arthurbenemann/QuadStepDriver/Gerber/QuadStepDriver.TXT

%
M48
M72
T01C0.0150
T02C0.0200
T03C0.0236
T04C0.0374
T05C0.0400
T06C0.0550
T07C0.0906
T08C0.1300
%
T01
X7240Y15015
X7240Y15390
X7240Y15790
X7640Y15790
X7640Y15390
X7640Y14990
X8040Y14990
X8040Y15390
X8040Y15790
X17083Y15790
X17483Y15790
X17883Y15790
X17883Y15390
X17883Y14990
X17483Y14990
X17483Y15390
X17083Y15390
X17083Y15015
X26925Y15015
X26925Y15390
X26925Y15790
X27325Y15790
X27325Y15390
X27325Y14990
X27725Y14990
X27725Y15390
X27725Y15790
X36768Y15790
X37168Y15790
X37568Y15790
X37568Y15390
X37568Y14990
X37168Y14990
X37168Y15390
X36768Y15390
X36768Y15015
T02
X36168Y14140
X35918Y13765
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
