arthurbenemann/QuadStepDriver/(list of files, cad)

Other CAD files:
StepDriver.X/l.obj
