arthurbenemann/QuadStepDriver/QuadStepDriver.brd

## EAGLE design QuadStepDriver.brd (2013-06-29)

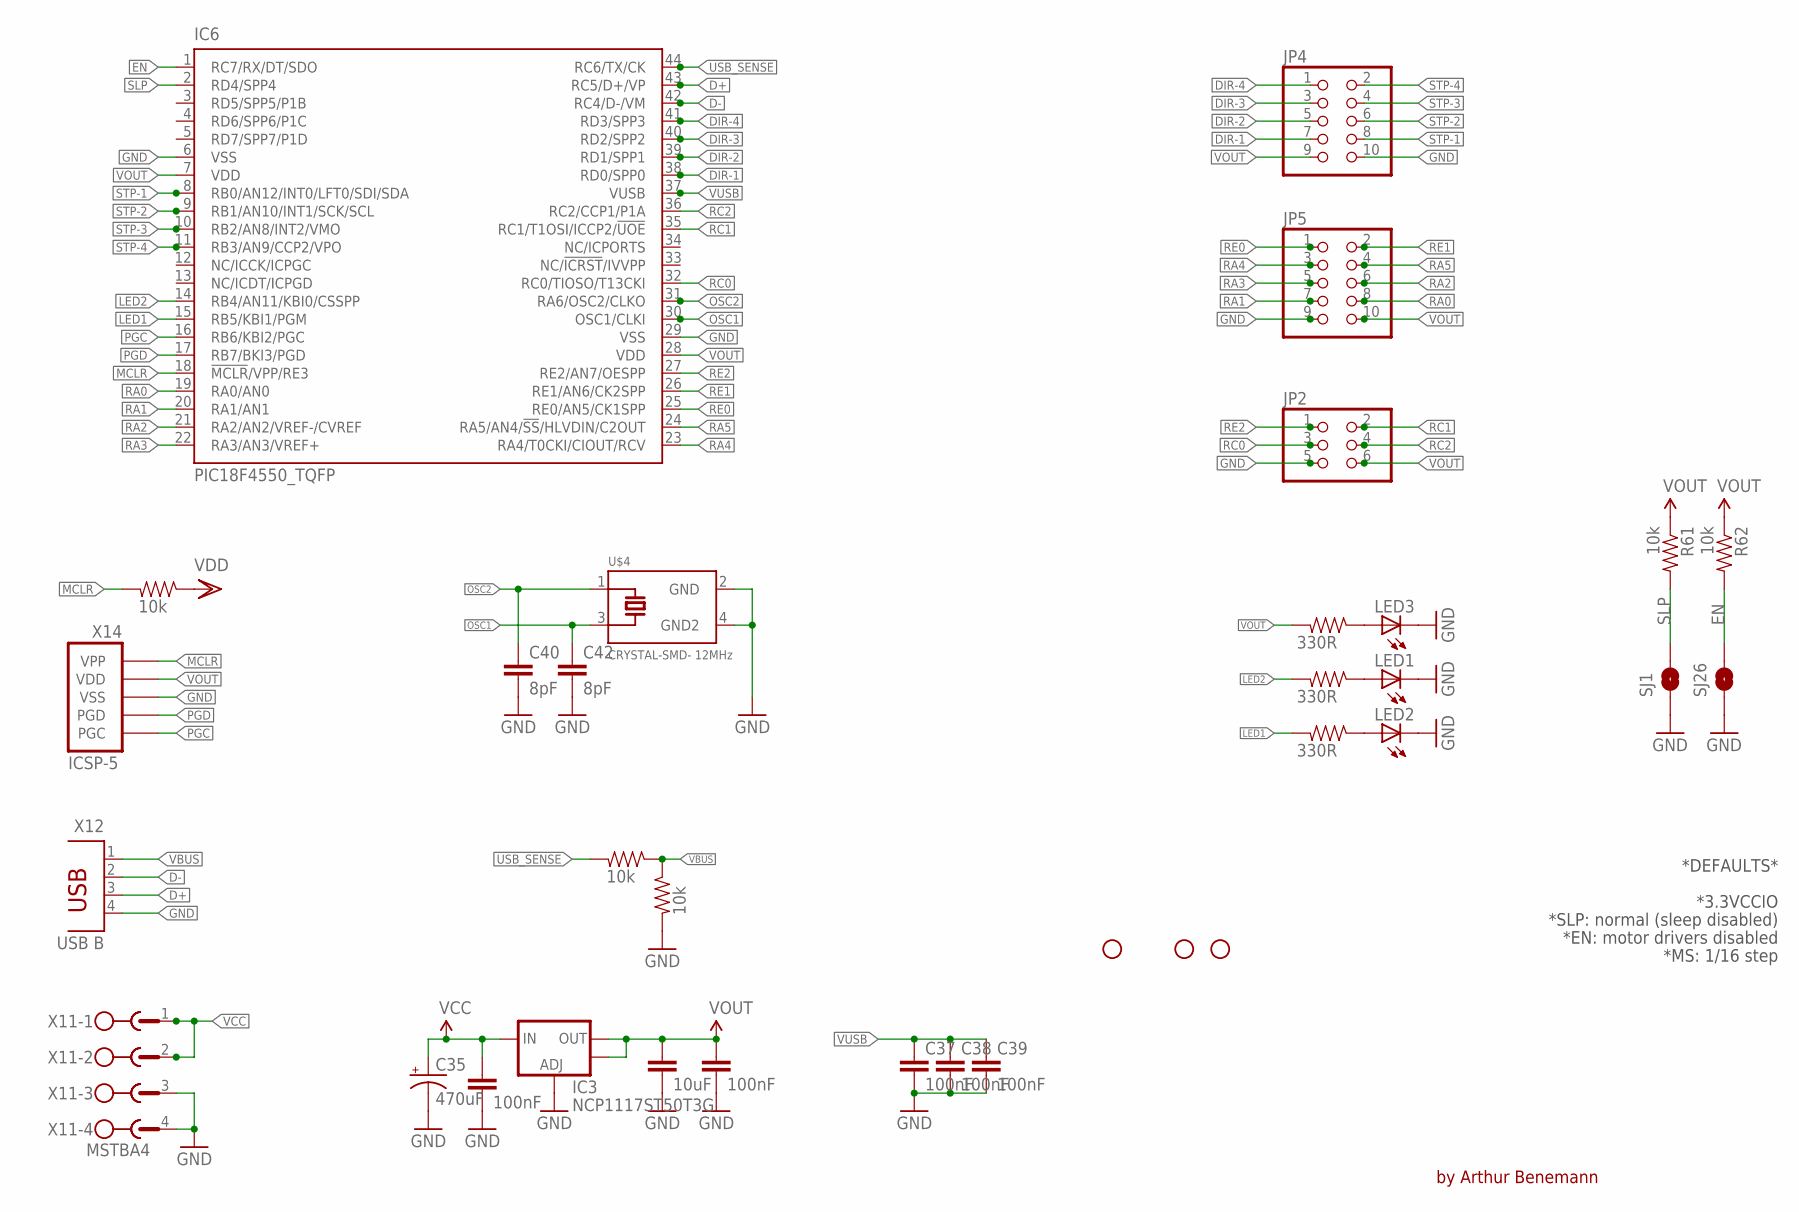
[picture p1: schematic QuadStepDriver.sch, sheet 1]

Parts:
C33: 10uF; 0805
C34, C36, C37, C38, C39: 100nF; 0805
C35: 470uF; PANASONIC_G
C40, C42: 8pF; 0603-CAP
IC3: NCP1117ST50T3G; SOT223
IC6: PIC18F4550_TQFP; TQFP44
JP2: PINHD-2X3; 2X03
JP4, JP5: PINHD-2X5; 2X05
JP9, JP10, JP12: STAND-OFF
LED1, LED2, LED3: LEDCHIPLED_0805; CHIPLED_0805
R33, R34, R35: 330R; 0805
R49, R50, R51: 10k; 0805
R61, R62: 10k; 0603-RES
SJ1, SJ26: SOLDERJUMPERNO; SJ_2S-NO
U$4: CRYSTAL-SMD- 12MHz; CRYSTAL-SMD-3.2X2.5
X11: MSTBA4
X12: USB B; PN61729
X14: ICSP-5; M05

Connections:
!MCLR: IC6.18 (!MCLR!/VPP/RE3), R51.2, X14.1 (VPP)
D+: IC6.43 (RC5/D+/VP), X12.3
D-: IC6.42 (RC4/D-/VM), X12.2
DIR-1: IC6.38 (RD0/SPP0), JP4.7; also elsewhere on the board
DIR-2: IC6.39 (RD1/SPP1), JP4.5; also elsewhere on the board
DIR-3: IC6.40 (RD2/SPP2), JP4.3; also elsewhere on the board
DIR-4: IC6.41 (RD3/SPP3), JP4.1; also elsewhere on the board
EN: IC6.1 (RC7/RX/DT/SDO), R62.2, SJ26.2; also elsewhere on the board
GND: C33.1, C34.1, C35.-, C36.1, C37.2, C38.2, C39.2, C40.2, C42.2, IC3.1 (ADJ), IC6.6 (VSS), IC6.29 (VSS), JP2.5, JP4.10, JP5.9, LED1.C, LED2.C, LED3.C, R50.2, SJ1.1, SJ26.1, U$4.2 (GND), U$4.4 (GND2), X11.3, X11.4, X12.4, X14.3 (VSS); also elsewhere on the board
LED1: IC6.15 (RB5/KBI1/PGM), R34.2
LED2: IC6.14 (RB4/AN11/KBI0/CSSPP), R33.2
unnamed: LED3.A, R35.1
unnamed: LED1.A, R33.1
unnamed: LED2.A, R34.1
OSC1: C42.1, IC6.30 (OSC1/CLKI), U$4.3 (OSC2)
OSC2: C40.1, IC6.31 (RA6/OSC2/CLKO), U$4.1 (OSC1)
PGC: IC6.16 (RB6/KBI2/PGC), X14.5 (PGC)
PGD: IC6.17 (RB7/BKI3/PGD), X14.4 (PGD)
RA0: IC6.19 (RA0/AN0), JP5.8
RA1: IC6.20 (RA1/AN1), JP5.7
RA2: IC6.21 (RA2/AN2/VREF-/CVREF), JP5.6
RA3: IC6.22 (RA3/AN3/VREF+), JP5.5
RA4: IC6.23 (RA4/T0CKI/CIOUT/RCV), JP5.3
RA5: IC6.24 (RA5/AN4/!SS!/HLVDIN/C2OUT), JP5.4
RC0: IC6.32 (RC0/TIOSO/T13CKI), JP2.3
RC1: IC6.35 (RC1/T1OSI/ICCP2/!UOE), JP2.2
RC2: IC6.36 (RC2/CCP1/P1A), JP2.4
RE0: IC6.25 (RE0/AN5/CK1SPP), JP5.1
RE1: IC6.26 (RE1/AN6/CK2SPP), JP5.2
RE2: IC6.27 (RE2/AN7/OESPP), JP2.1
SLP: IC6.2 (RD4/SPP4), R61.2, SJ1.2; also elsewhere on the board
STP-1: IC6.8 (RB0/AN12/INT0/LFT0/SDI/SDA), JP4.8; also elsewhere on the board
STP-2: IC6.9 (RB1/AN10/INT1/SCK/SCL), JP4.6; also elsewhere on the board
STP-3: IC6.10 (RB2/AN8/INT2/VMO), JP4.4; also elsewhere on the board
STP-4: IC6.11 (RB3/AN9/CCP2/VPO), JP4.2; also elsewhere on the board
USB_SENSE: IC6.44 (RC6/TX/CK), R49.2
VBUS: R49.1, R50.1, X12.1
VCC: C35.+, C36.2, IC3.3 (IN), X11.1, X11.2; also elsewhere on the board
VOUT: C33.2, C34.2, IC3.2 (OUT), IC3.4 (OUT), IC6.7 (VDD), IC6.28 (VDD), JP2.6, JP4.9, JP5.10, R35.2, R51.1, R61.1, R62.1, X14.2 (VDD); also elsewhere on the board
VUSB: C37.1, C38.1, C39.1, IC6.37 (VUSB)

Notes on the sheet:
*DEFAULTS*
*MS: 1/16 step
*3.3VCCIO
*EN: motor drivers disabled
*SLP: normal (sleep disabled)
by Arthur Benemann

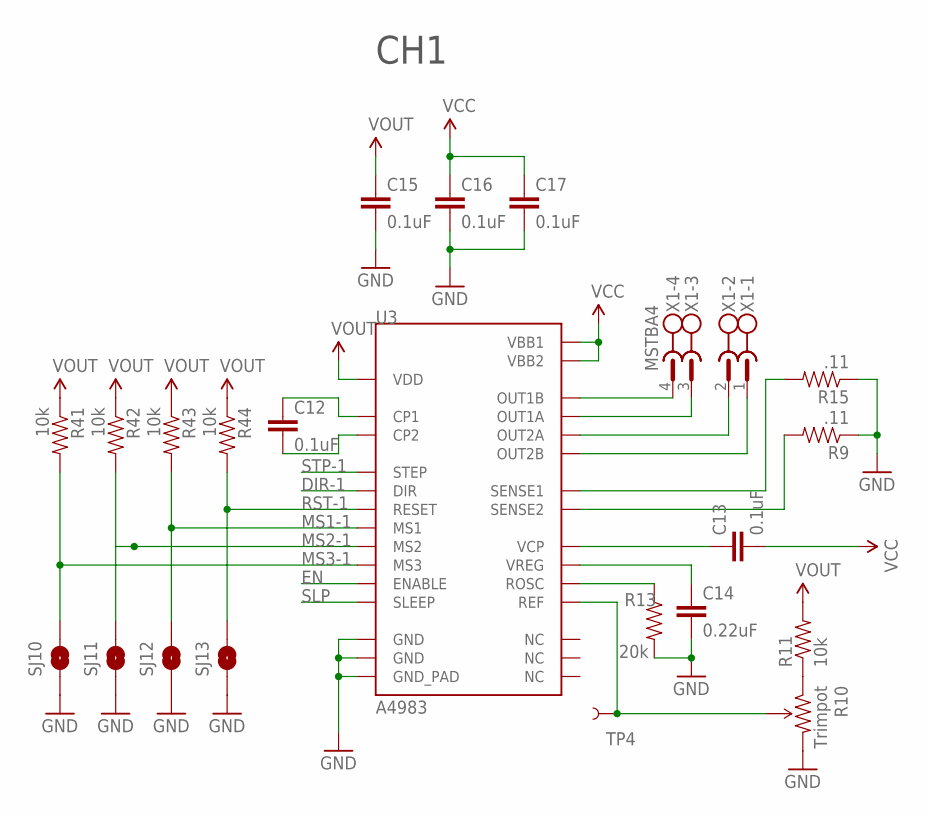
[picture p2: schematic QuadStepDriver.sch, sheet 2]

Parts:
C12, C13, C15, C16, C17: 0.1uF; 0603-CAP
C14: 0.22uF; 0603-CAP
R9, R15: .11; R2010
R10: Trimpot; TRIMPOT-3MM
R11, R41, R42, R43, R44: 10k; 0603-RES
R13: 20k; 0603-RES
SJ10, SJ11, SJ12, SJ13: SOLDERJUMPERNO; SJ_2S-NO
TP4: TEST-POINT3X5; PAD.03X.05
U3: A4983; QFN-28-5MM
X1: MSTBA4; MPN 1757268

Connections:
DIR-1: U3.P$19 (DIR); also elsewhere on the board
EN: U3.P$2 (ENABLE); also elsewhere on the board
GND: C14.2, C15.2, C16.2, C17.2, R9.1, R10.3 (CW), R13.2, R15.1, SJ10.1, SJ11.1, SJ12.1, SJ13.1, U3.P$3 (GND), U3.P$18 (GND), U3.P$29 (GND_PAD); also elsewhere on the board
MS1-1: R43.2, SJ12.2, U3.P$9 (MS1)
MS2-1: R42.2, SJ11.2, U3.P$10 (MS2)
MS3-1: R41.2, SJ10.2, U3.P$11 (MS3)
unnamed: R9.2, U3.P$27 (SENSE2)
unnamed: R15.2, U3.P$23 (SENSE1)
unnamed: R10.1 (CCW), R11.1
unnamed: C13.1, U3.P$6 (VCP)
unnamed: C14.1, U3.P$8 (VREG)
unnamed: R13.1, U3.P$13 (ROSC)
unnamed: R10.2 (WIPER), TP4.P$1, U3.P$17 (REF)
unnamed: C12.1, U3.P$4 (CP1)
unnamed: C12.2, U3.P$5 (CP2)
unnamed: U3.P$21 (OUT1B), X1.4
unnamed: U3.P$24 (OUT1A), X1.3
unnamed: U3.P$26 (OUT2A), X1.2
unnamed: U3.P$1 (OUT2B), X1.1
RST-1: R44.2, SJ13.2, U3.P$12 (RESET)
SLP: U3.P$14 (SLEEP); also elsewhere on the board
STP-1: U3.P$16 (STEP); also elsewhere on the board
VCC: C13.2, C16.1, C17.1, U3.P$22 (VBB1), U3.P$28 (VBB2); also elsewhere on the board
VOUT: C15.1, R11.2, R41.1, R42.1, R43.1, R44.1, U3.P$15 (VDD); also elsewhere on the board

Notes on the sheet:
CH1

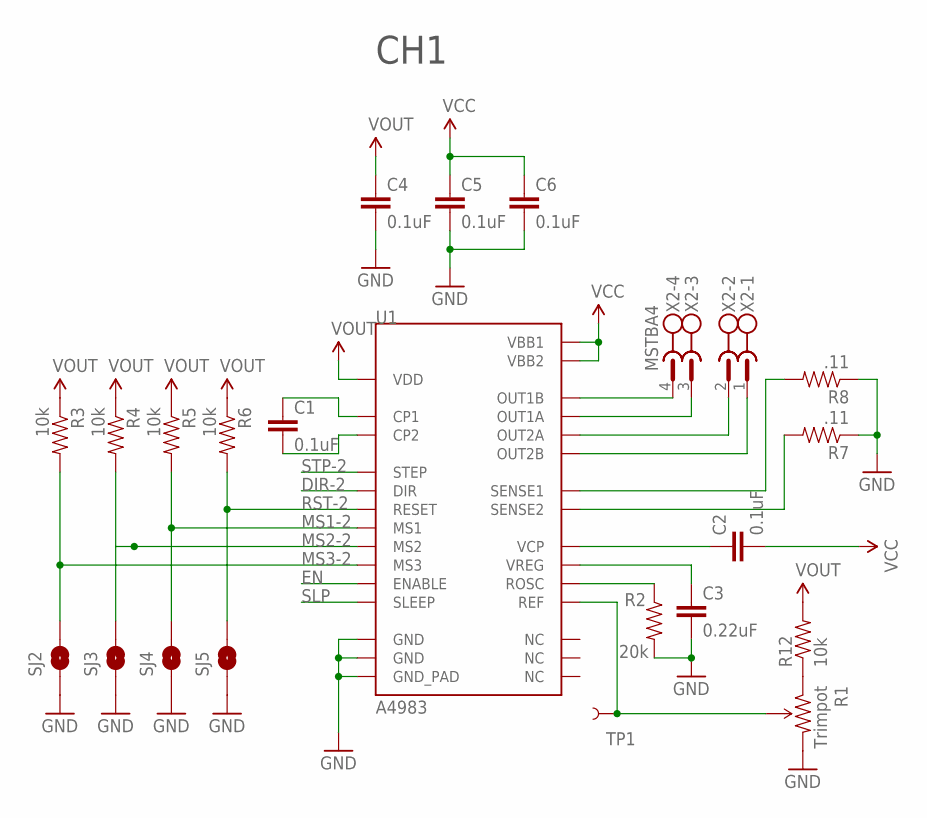
[picture p3: schematic QuadStepDriver.sch, sheet 3]

Parts:
C1, C2, C4, C5, C6: 0.1uF; 0603-CAP
C3: 0.22uF; 0603-CAP
R1: Trimpot; TRIMPOT-3MM
R2: 20k; 0603-RES
R3, R4, R5, R6, R12: 10k; 0603-RES
R7, R8: .11; R2010
SJ2, SJ3, SJ4, SJ5: SOLDERJUMPERNO; SJ_2S-NO
TP1: TEST-POINT3X5; PAD.03X.05
U1: A4983; QFN-28-5MM
X2: MSTBA4; MPN 1757268

Connections:
DIR-2: U1.P$19 (DIR); also elsewhere on the board
EN: U1.P$2 (ENABLE); also elsewhere on the board
GND: C3.2, C4.2, C5.2, C6.2, R1.3 (CW), R2.2, R7.1, R8.1, SJ2.1, SJ3.1, SJ4.1, SJ5.1, U1.P$3 (GND), U1.P$18 (GND), U1.P$29 (GND_PAD); also elsewhere on the board
MS1-2: R5.2, SJ4.2, U1.P$9 (MS1)
MS2-2: R4.2, SJ3.2, U1.P$10 (MS2)
MS3-2: R3.2, SJ2.2, U1.P$11 (MS3)
unnamed: C2.1, U1.P$6 (VCP)
unnamed: C3.1, U1.P$8 (VREG)
unnamed: R2.1, U1.P$13 (ROSC)
unnamed: R1.2 (WIPER), TP1.P$1, U1.P$17 (REF)
unnamed: C1.1, U1.P$4 (CP1)
unnamed: C1.2, U1.P$5 (CP2)
unnamed: U1.P$24 (OUT1A), X2.3
unnamed: U1.P$26 (OUT2A), X2.2
unnamed: U1.P$1 (OUT2B), X2.1
unnamed: U1.P$21 (OUT1B), X2.4
unnamed: R7.2, U1.P$27 (SENSE2)
unnamed: R8.2, U1.P$23 (SENSE1)
unnamed: R1.1 (CCW), R12.1
RST-2: R6.2, SJ5.2, U1.P$12 (RESET)
SLP: U1.P$14 (SLEEP); also elsewhere on the board
STP-2: U1.P$16 (STEP); also elsewhere on the board
VCC: C2.2, C5.1, C6.1, U1.P$22 (VBB1), U1.P$28 (VBB2); also elsewhere on the board
VOUT: C4.1, R3.1, R4.1, R5.1, R6.1, R12.2, U1.P$15 (VDD); also elsewhere on the board

Notes on the sheet:
CH1

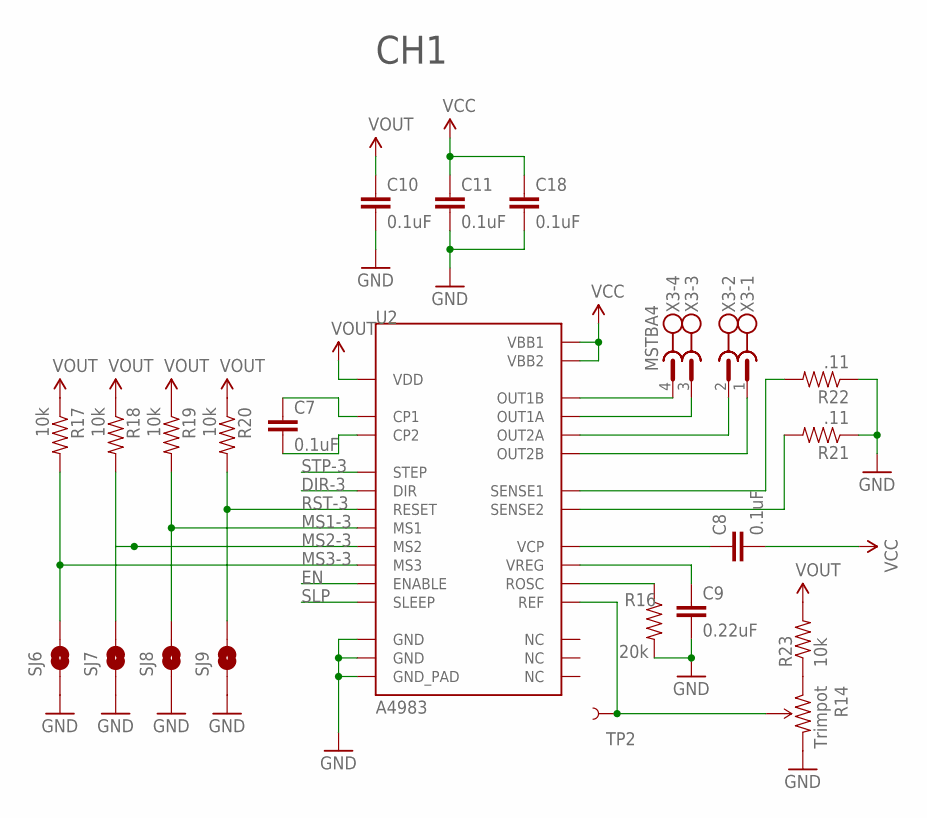
[picture p4: schematic QuadStepDriver.sch, sheet 4]

Parts:
C7, C8, C10, C11, C18: 0.1uF; 0603-CAP
C9: 0.22uF; 0603-CAP
R14: Trimpot; TRIMPOT-3MM
R16: 20k; 0603-RES
R17, R18, R19, R20, R23: 10k; 0603-RES
R21, R22: .11; R2010
SJ6, SJ7, SJ8, SJ9: SOLDERJUMPERNO; SJ_2S-NO
TP2: TEST-POINT3X5; PAD.03X.05
U2: A4983; QFN-28-5MM
X3: MSTBA4; MPN 1757268

Connections:
DIR-3: U2.P$19 (DIR); also elsewhere on the board
EN: U2.P$2 (ENABLE); also elsewhere on the board
GND: C9.2, C10.2, C11.2, C18.2, R14.3 (CW), R16.2, R21.1, R22.1, SJ6.1, SJ7.1, SJ8.1, SJ9.1, U2.P$3 (GND), U2.P$18 (GND), U2.P$29 (GND_PAD); also elsewhere on the board
MS1-3: R19.2, SJ8.2, U2.P$9 (MS1)
MS2-3: R18.2, SJ7.2, U2.P$10 (MS2)
MS3-3: R17.2, SJ6.2, U2.P$11 (MS3)
unnamed: C8.1, U2.P$6 (VCP)
unnamed: C9.1, U2.P$8 (VREG)
unnamed: R16.1, U2.P$13 (ROSC)
unnamed: R14.2 (WIPER), TP2.P$1, U2.P$17 (REF)
unnamed: C7.1, U2.P$4 (CP1)
unnamed: C7.2, U2.P$5 (CP2)
unnamed: U2.P$24 (OUT1A), X3.3
unnamed: U2.P$26 (OUT2A), X3.2
unnamed: U2.P$1 (OUT2B), X3.1
unnamed: U2.P$21 (OUT1B), X3.4
unnamed: R21.2, U2.P$27 (SENSE2)
unnamed: R22.2, U2.P$23 (SENSE1)
unnamed: R14.1 (CCW), R23.1
RST-3: R20.2, SJ9.2, U2.P$12 (RESET)
SLP: U2.P$14 (SLEEP); also elsewhere on the board
STP-3: U2.P$16 (STEP); also elsewhere on the board
VCC: C8.2, C11.1, C18.1, U2.P$22 (VBB1), U2.P$28 (VBB2); also elsewhere on the board
VOUT: C10.1, R17.1, R18.1, R19.1, R20.1, R23.2, U2.P$15 (VDD); also elsewhere on the board

Notes on the sheet:
CH1

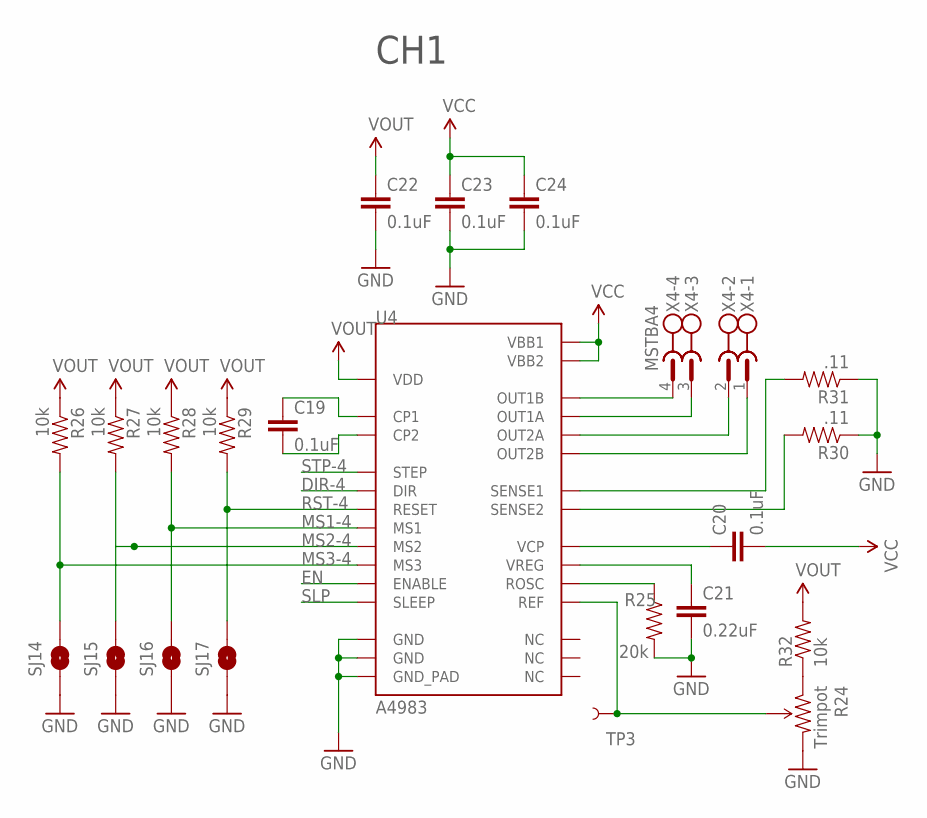
[picture p5: schematic QuadStepDriver.sch, sheet 5]

Parts:
C19, C20, C22, C23, C24: 0.1uF; 0603-CAP
C21: 0.22uF; 0603-CAP
R24: Trimpot; TRIMPOT-3MM
R25: 20k; 0603-RES
R26, R27, R28, R29, R32: 10k; 0603-RES
R30, R31: .11; R2010
SJ14, SJ15, SJ16, SJ17: SOLDERJUMPERNO; SJ_2S-NO
TP3: TEST-POINT3X5; PAD.03X.05
U4: A4983; QFN-28-5MM
X4: MSTBA4; MPN 1757268

Connections:
DIR-4: U4.P$19 (DIR); also elsewhere on the board
EN: U4.P$2 (ENABLE); also elsewhere on the board
GND: C21.2, C22.2, C23.2, C24.2, R24.3 (CW), R25.2, R30.1, R31.1, SJ14.1, SJ15.1, SJ16.1, SJ17.1, U4.P$3 (GND), U4.P$18 (GND), U4.P$29 (GND_PAD); also elsewhere on the board
MS1-4: R28.2, SJ16.2, U4.P$9 (MS1)
MS2-4: R27.2, SJ15.2, U4.P$10 (MS2)
MS3-4: R26.2, SJ14.2, U4.P$11 (MS3)
unnamed: C20.1, U4.P$6 (VCP)
unnamed: C21.1, U4.P$8 (VREG)
unnamed: R25.1, U4.P$13 (ROSC)
unnamed: R24.2 (WIPER), TP3.P$1, U4.P$17 (REF)
unnamed: C19.1, U4.P$4 (CP1)
unnamed: C19.2, U4.P$5 (CP2)
unnamed: U4.P$24 (OUT1A), X4.3
unnamed: U4.P$26 (OUT2A), X4.2
unnamed: U4.P$1 (OUT2B), X4.1
unnamed: U4.P$21 (OUT1B), X4.4
unnamed: R30.2, U4.P$27 (SENSE2)
unnamed: R31.2, U4.P$23 (SENSE1)
unnamed: R24.1 (CCW), R32.1
RST-4: R29.2, SJ17.2, U4.P$12 (RESET)
SLP: U4.P$14 (SLEEP); also elsewhere on the board
STP-4: U4.P$16 (STEP); also elsewhere on the board
VCC: C20.2, C23.1, C24.1, U4.P$22 (VBB1), U4.P$28 (VBB2); also elsewhere on the board
VOUT: C22.1, R26.1, R27.1, R28.1, R29.1, R32.2, U4.P$15 (VDD); also elsewhere on the board

Notes on the sheet:
CH1

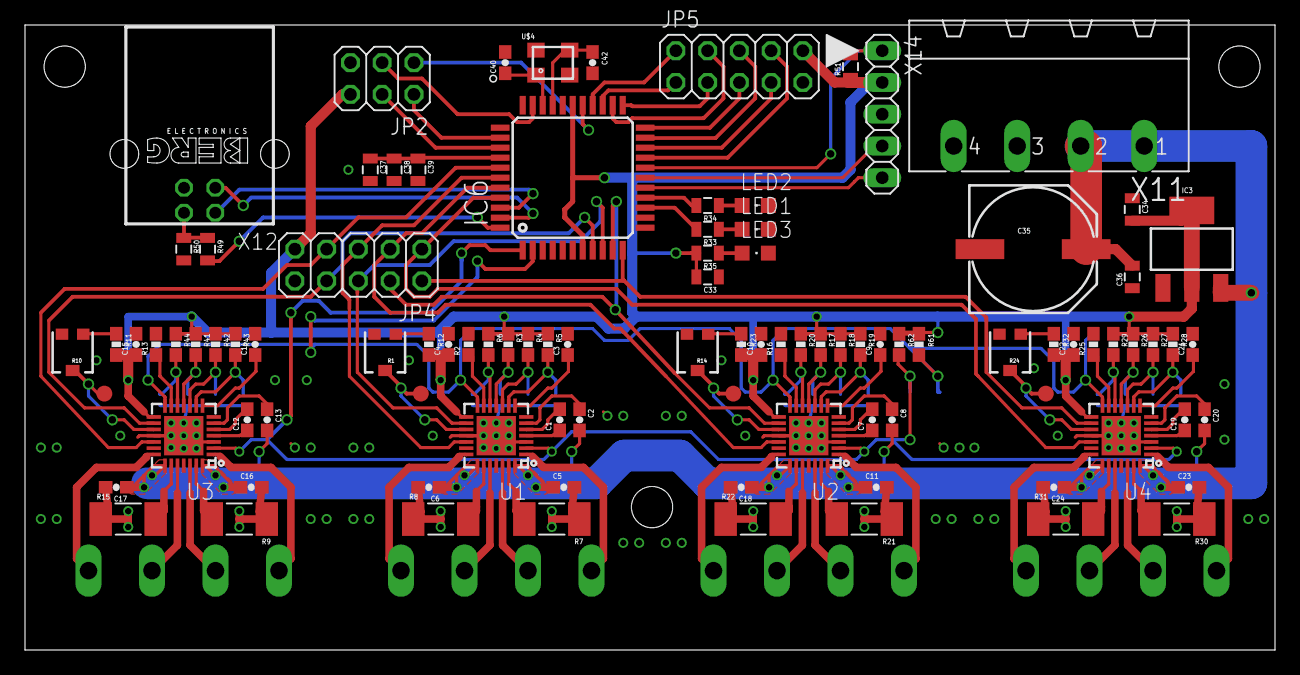
[picture p6: board QuadStepDriver.brd from above]

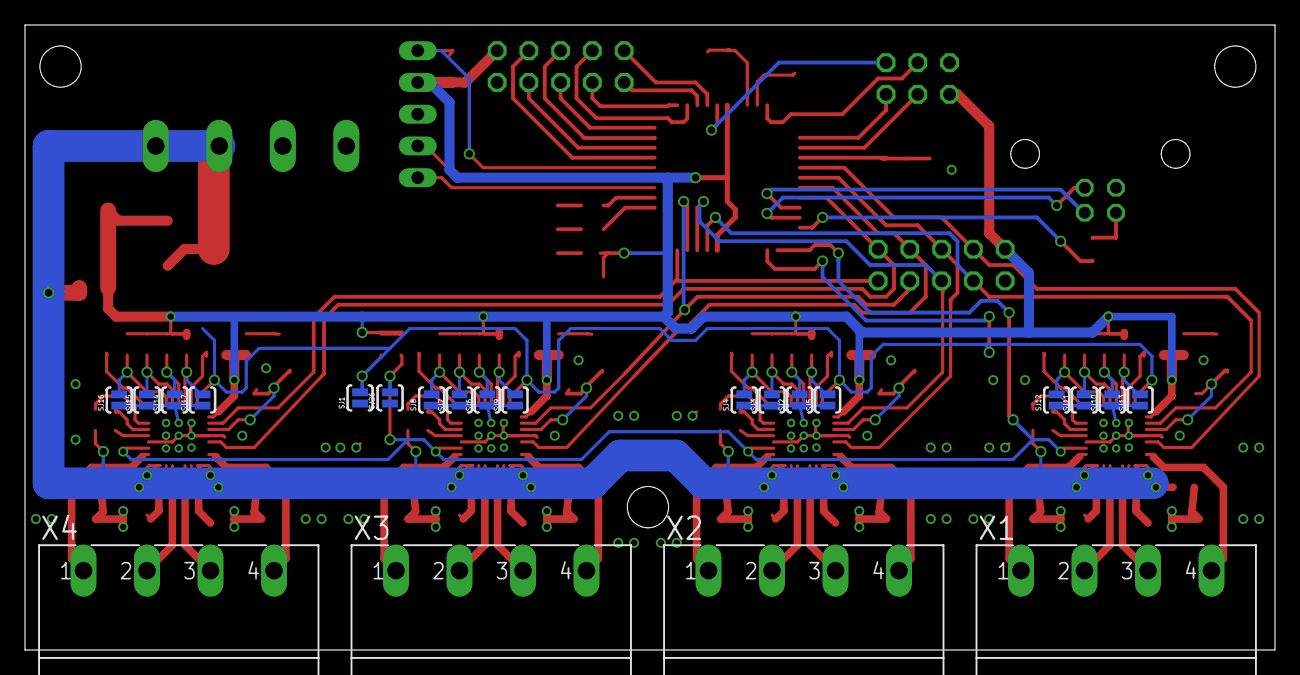
[picture p7: board QuadStepDriver.brd from below]

Board: 2 copper layers, 100.0 x 50.0 mm, 122 parts (22 on the bottom side), 108 nets.
