arthurbenemann/QuadStepDriver/(commit log)

2013-05-24 Adding some already designed boards
    [BigEasyDriver_v12.brd, BigEasyDriver_v12.sch, quadstep-v11assembly.brd, quadstep-v11assembly.sch]
2013-05-24 Finished layout of one quadrant of the board (CH3).
    [quadstep-v11assembly.brd, quadstep-v11assembly.sch]
2013-05-24 Clean-up of the layout.
    [quadstep-v11assembly.brd, quadstep-v11assembly.sch]
2013-05-24 Layout copied to the other three quadrants.
    [quadstep-v11assembly.brd, quadstep-v11assembly.sch]
2013-05-24 Adding a uC with USB
    [quadstep-v11assembly.brd, quadstep-v11assembly.sch]
2013-05-25 Improving the layout
    [quadstep-v11assembly.brd, quadstep-v11assembly.sch]
2013-05-25 Layout ....
    [quadstep-v11assembly.brd, quadstep-v11assembly.sch]
2013-05-31 Layout with new TQFP IC
    [quadstep-v11assembly.brd, quadstep-v11assembly.sch]
2013-05-31 Deleting unused files.
    [BigEasyDriver_v12.brd, BigEasyDriver_v12.sch]
2013-05-31 Renaming files
    [QuadStepDriver.brd, QuadStepDriver.sch]
2013-05-31 Just cleaning up the schematic
    [QuadStepDriver.brd, QuadStepDriver.sch]
2013-06-06 PCB: Finalizando Gerbers
    [QuadStepDriver.GBL, QuadStepDriver.GBO, QuadStepDriver.GBP, QuadStepDriver.GBS, QuadStepDriver.GTL, QuadStepDriver.GTO, QuadStepDriver.GTP, QuadStepDriver.GTS]
2013-06-29 Changing some components values, and organizing component values placement
    [QuadStepDriver.brd, QuadStepDriver.sch]
2013-06-29 Fixing some unconneted routes from board REV1.
    PGC and power input GND are now connected.
    [QuadStepDriver.brd, QuadStepDriver.sch]
2013-07-01 Code: Adding just enought code to make the motors spin.
    [l.obj]
